D-uality/BitFusion-Robocup-Asia-Pacific/RPi Zero 2W/Design/Claw/Claw Mechanism/Claw Mechanism - Right Main Arm.stl

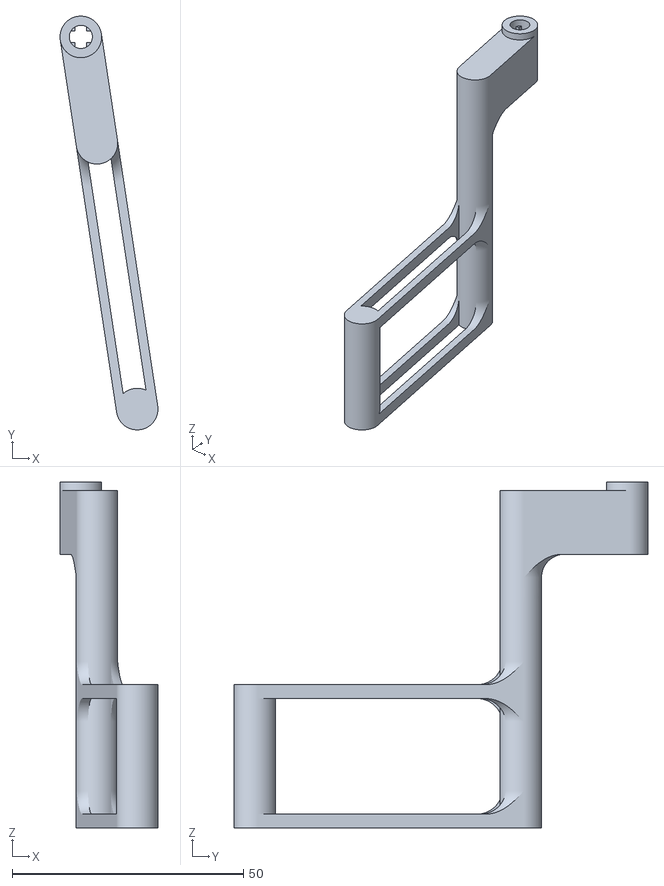
[picture p6: CAD file, 2024-09-25]
RPi Zero 2W/Design/Claw/Claw Mechanism/Claw Mechanism - Right Main Arm.stl
21.2 x 89.5 x 74.8
