D-uality/BitFusion-Robocup-Asia-Pacific/Design/RPi 5/Base Boards/Base Board - RPi 5 - Base Board - RPi 5.stl

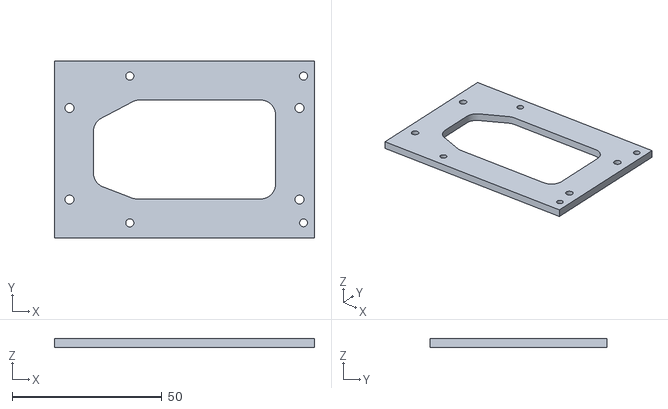
[picture p7: CAD file, 2024-06-18]
Design/RPi 5/Base Boards/Base Board - RPi 5 - Base Board - RPi 5.stl
86.8 x 59.0 x 3.00
