D-uality/BitFusion-Robocup-Asia-Pacific/Design/RPi 5/Battery/Battery Connector - Battery Connector.stl

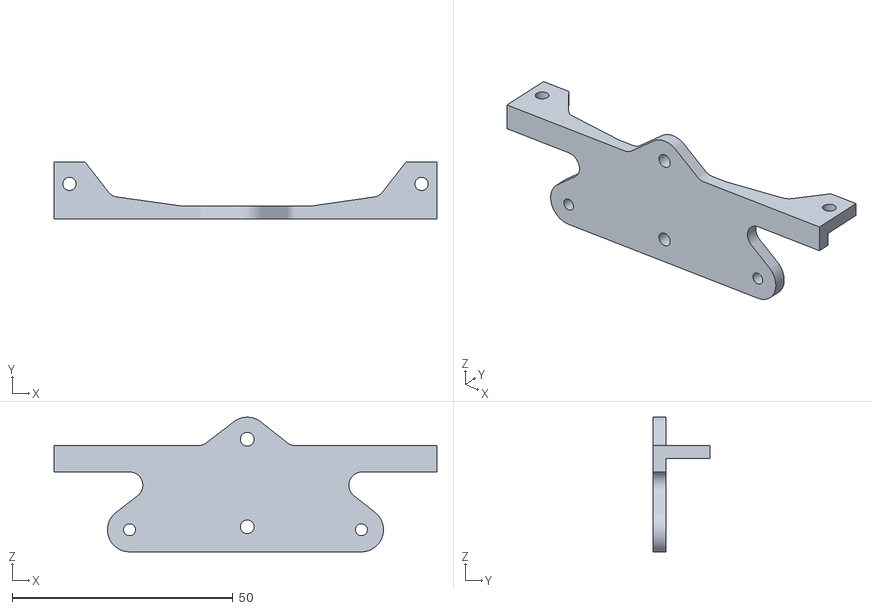
[picture p8: CAD file, 2024-06-18]
Design/RPi 5/Battery/Battery Connector - Battery Connector.stl
86.8 x 13.0 x 30.5
