D-uality/BitFusion-Robocup-Asia-Pacific/Design/RPi 5/Camera/Reflective Mirror - Reflective Mirror.stl

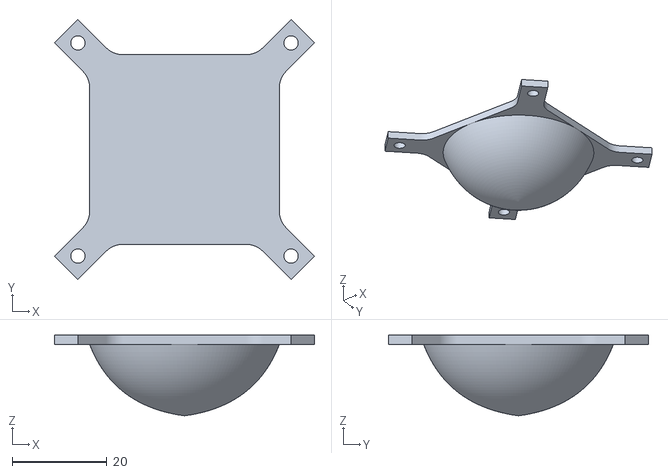
[picture p9: CAD file, 2024-06-18]
Design/RPi 5/Camera/Reflective Mirror - Reflective Mirror.stl
54.8 x 54.8 x 17.0
