D-uality/BitFusion-Robocup-Asia-Pacific/RPi Zero 2W/Design/Claw/Claw Frame/Claw Frame - Claw Vertically Up - Claw Frame.stl

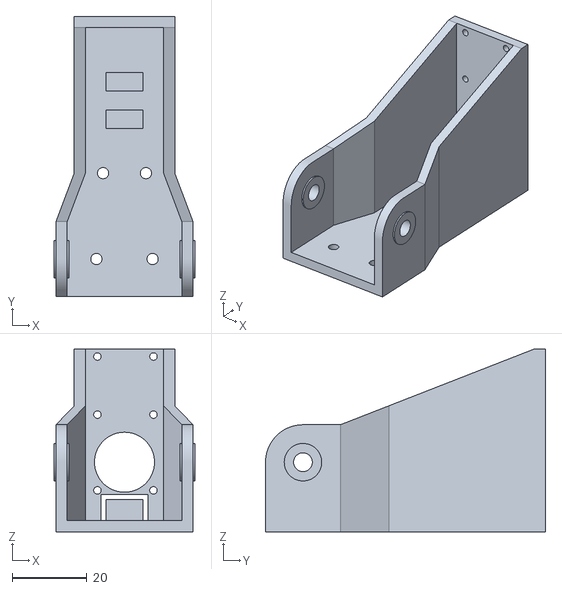
[picture p10: CAD file, 2024-06-18]
RPi Zero 2W/Design/Claw/Claw Frame/Claw Frame - Claw Vertically Up - Claw Frame.stl
37.6 x 74.7 x 48.8
