D-uality/BitFusion-Robocup-Asia-Pacific/RPi Zero 2W/Design/Claw/Claw Mechanism/Claw Mechanism - Left Bottom Cuff.stl

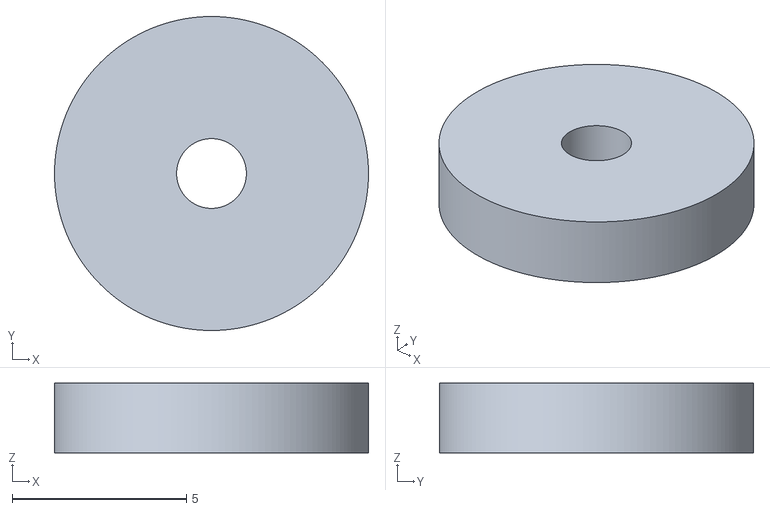
[picture p11: CAD file, 2024-09-25]
RPi Zero 2W/Design/Claw/Claw Mechanism/Claw Mechanism - Left Bottom Cuff.stl
9.00 x 9.00 x 2.00
