D-uality/BitFusion-Robocup-Asia-Pacific/RPi Zero 2W/Design/Claw/Drive Gears/Drive Gears - Drive Gear Front.stl

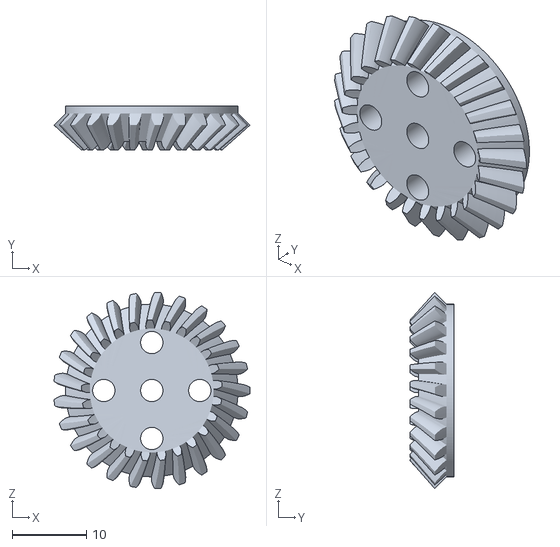
[picture p12: CAD file, 2024-06-18]
RPi Zero 2W/Design/Claw/Drive Gears/Drive Gears - Drive Gear Front.stl
26.4 x 5.92 x 26.4
