D-uality/BitFusion-Robocup-Asia-Pacific/RPi Zero 2W/Design/Claw/Rotating Frame/Rotating Frame - Rotating Frame.stl

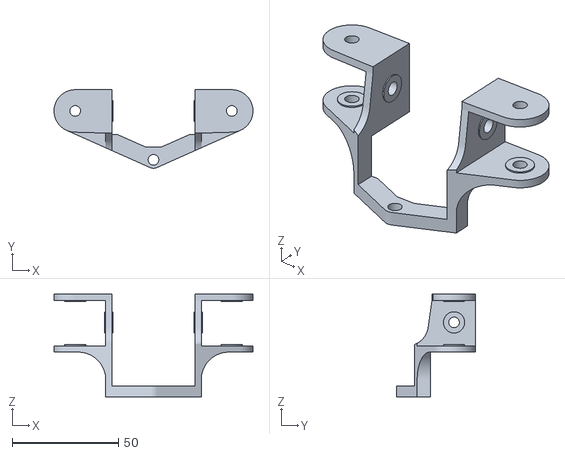
[picture p13: CAD file, 2024-09-07]
RPi Zero 2W/Design/Claw/Rotating Frame/Rotating Frame - Rotating Frame.stl
93.7 x 37.0 x 48.3
