D-uality/BitFusion-Robocup-Asia-Pacific/RPi Zero 2W/Design/Claw/Side Gears/Claw - Spiral Bevel 1M 15T 32deg.stl

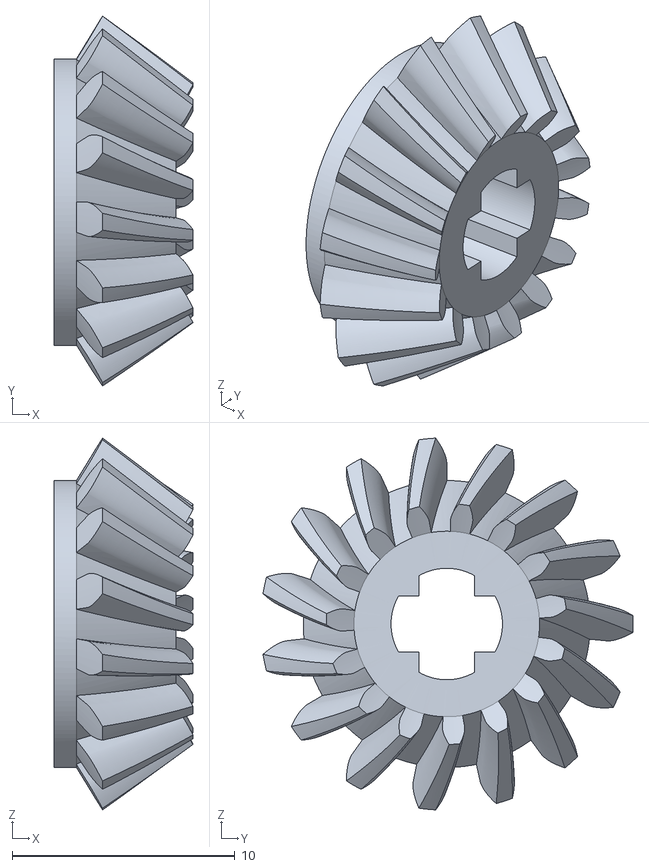
[picture p14: CAD file, 2024-06-18]
RPi Zero 2W/Design/Claw/Side Gears/Claw - Spiral Bevel 1M 15T 32deg.stl
6.23 x 16.6 x 16.7
