D-uality/BitFusion-Robocup-Asia-Pacific/RPi Zero 2W/Design/Robot/Lower Parts - Touch Frame.stl

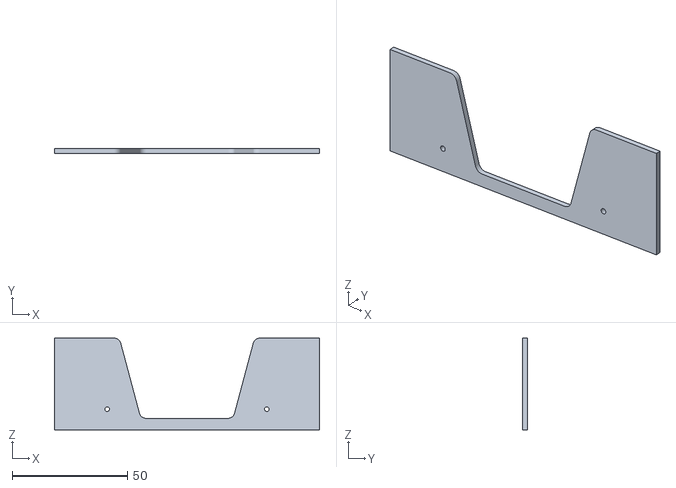
[picture p15: CAD file, 2024-10-12]
RPi Zero 2W/Design/Robot/Lower Parts - Touch Frame.stl
114.8 x 2.00 x 39.8
