D-uality/BitFusion-Robocup-Asia-Pacific/RPi Zero 2W/Design/Test/Lower Parts (22 deg).stl

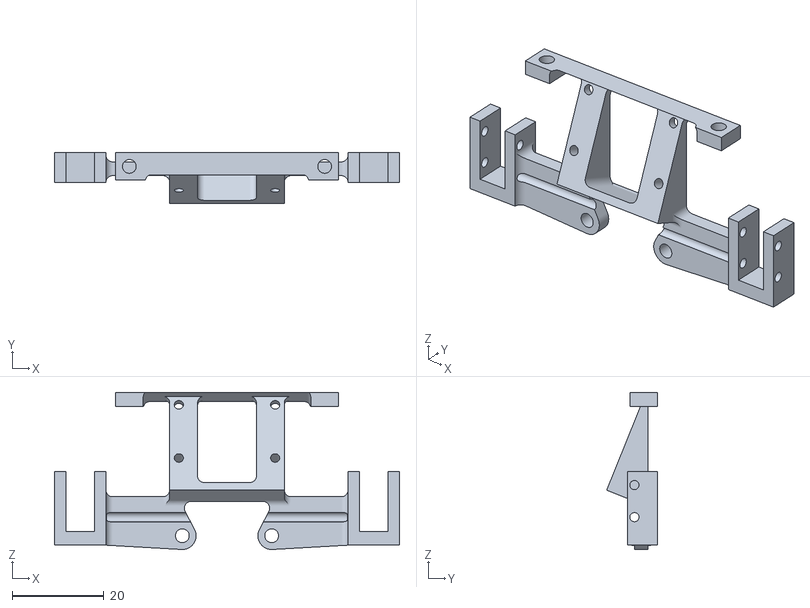
[picture p16: CAD file, 2024-07-22]
RPi Zero 2W/Design/Test/Lower Parts (22 deg).stl
75.2 x 11.0 x 34.2
