D-uality/BitFusion-Robocup-Asia-Pacific/Design/RPi 5/Base Boards/Base Board - Servos - Servo Base Board.stl

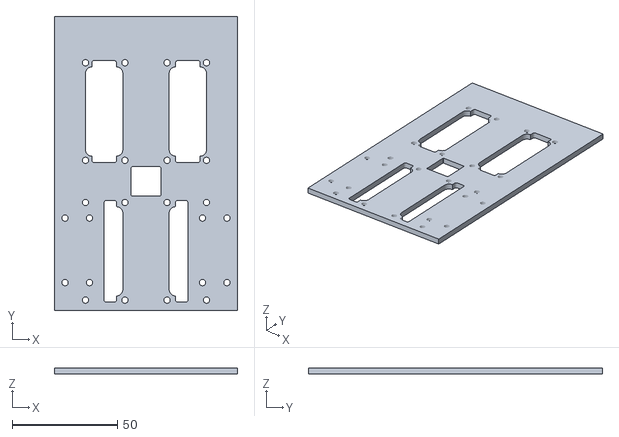
[picture p17: CAD file, 2024-06-18]
Design/RPi 5/Base Boards/Base Board - Servos - Servo Base Board.stl
86.8 x 139.6 x 3.00
