D-uality/BitFusion-Robocup-Asia-Pacific/Design/RPi 5/Battery/DoveTail - Battery Holder Dovetail.stl

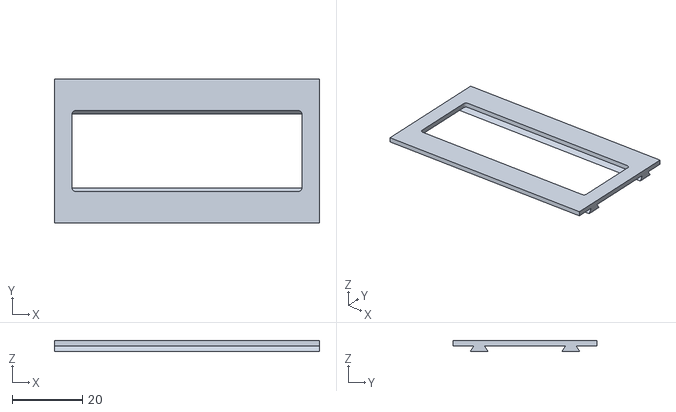
[picture p18: CAD file, 2024-05-27]
Design/RPi 5/Battery/DoveTail - Battery Holder Dovetail.stl
75.2 x 41.0 x 3.00
