D-uality/BitFusion-Robocup-Asia-Pacific/Design/RPi 5/Camera/Camera Frame - Camera Frame.stl

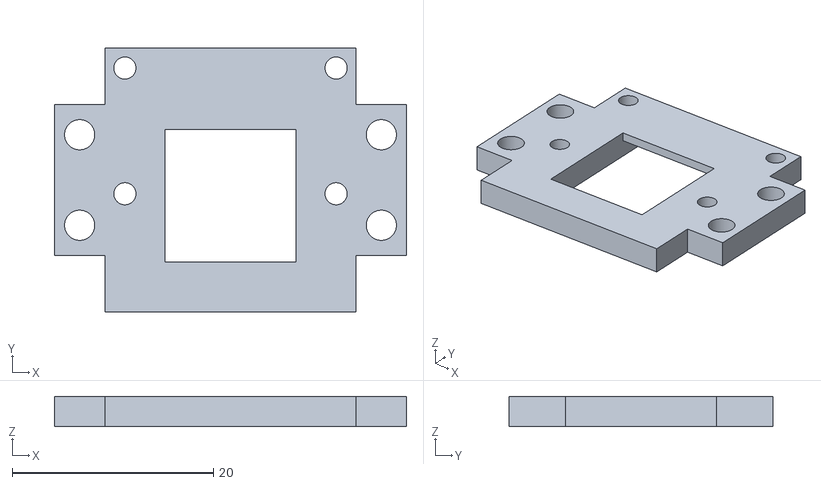
[picture p19: CAD file, 2024-06-18]
Design/RPi 5/Camera/Camera Frame - Camera Frame.stl
35.0 x 26.3 x 3.00
