D-uality/BitFusion-Robocup-Asia-Pacific/RPi Zero 2W/Design/Claw/Side Gears/Claw - Spiral Bevel 1M 24T 58deg.stl

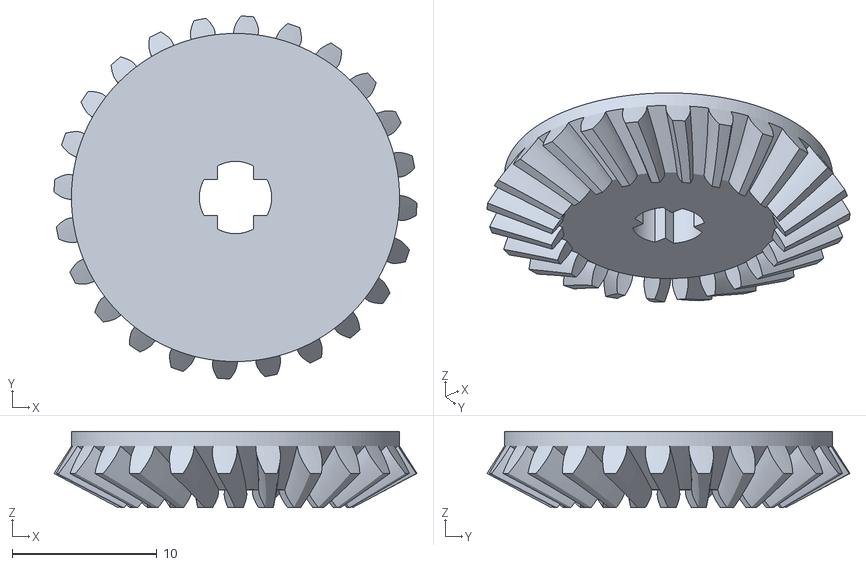
[picture p21: CAD file, 2024-06-18]
RPi Zero 2W/Design/Claw/Side Gears/Claw - Spiral Bevel 1M 24T 58deg.stl
25.1 x 25.1 x 5.26
