D-uality/BitFusion-Robocup-Asia-Pacific/RPi Zero 2W/Design/Robot/Touch Frame Back - Touch Frame Back.stl

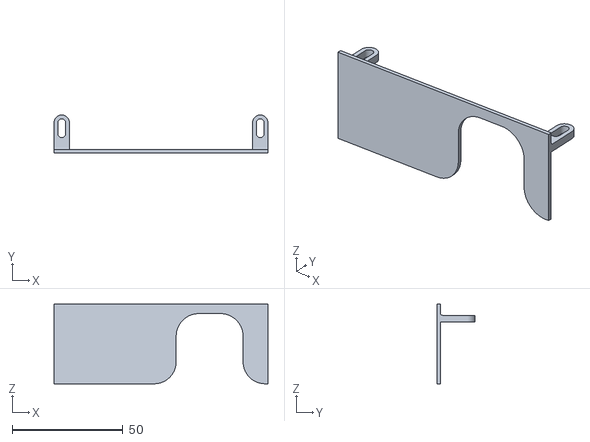
[picture p22: CAD file, 2024-10-12]
RPi Zero 2W/Design/Robot/Touch Frame Back - Touch Frame Back.stl
96.8 x 17.2 x 36.0
