D-uality/BitFusion-Robocup-Asia-Pacific/RPi Zero 2W/Design/Test/Lower Parts (20 deg).stl

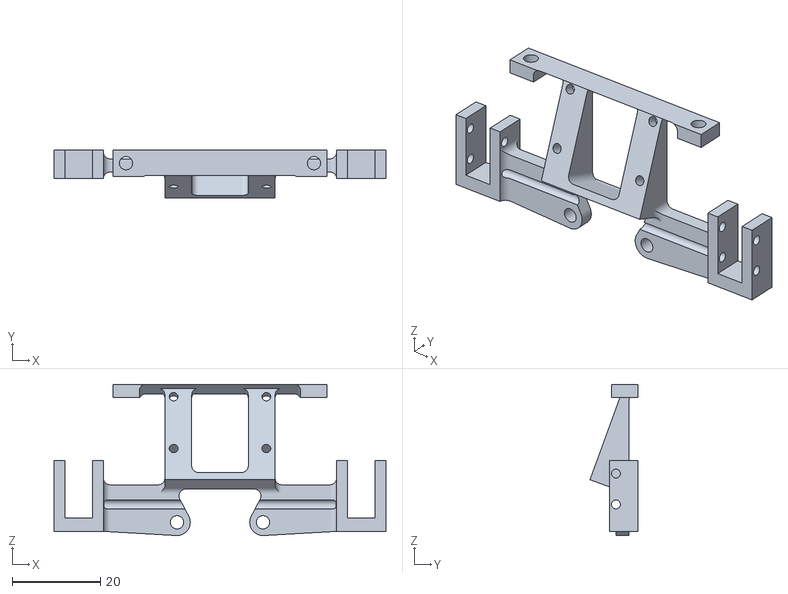
[picture p23: CAD file, 2024-07-22]
RPi Zero 2W/Design/Test/Lower Parts (20 deg).stl
75.2 x 10.9 x 34.2
