D-uality/BitFusion-Robocup-Asia-Pacific/Design/RPi 5/Battery/DoveTail - Test Piece.stl

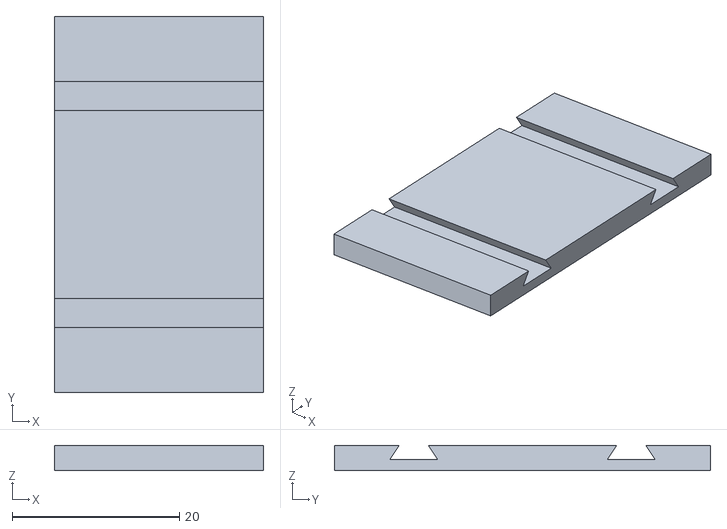
[picture p24: CAD file, 2024-05-27]
Design/RPi 5/Battery/DoveTail - Test Piece.stl
25.0 x 45.0 x 3.00
