D-uality/BitFusion-Robocup-Asia-Pacific/RPi Zero 2W/Design/Robot/Handle - Tilt Holder.stl

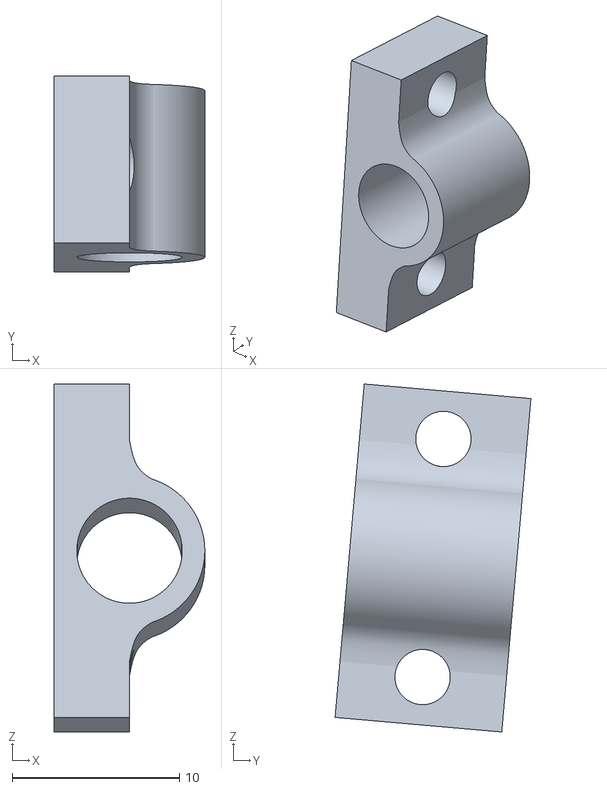
[picture p25: CAD file, 2024-10-05]
RPi Zero 2W/Design/Robot/Handle - Tilt Holder.stl
9.00 x 11.7 x 20.8
