D-uality/BitFusion-Robocup-Asia-Pacific/RPi Zero 2W/Design/Test/Lower Parts (10 deg).stl

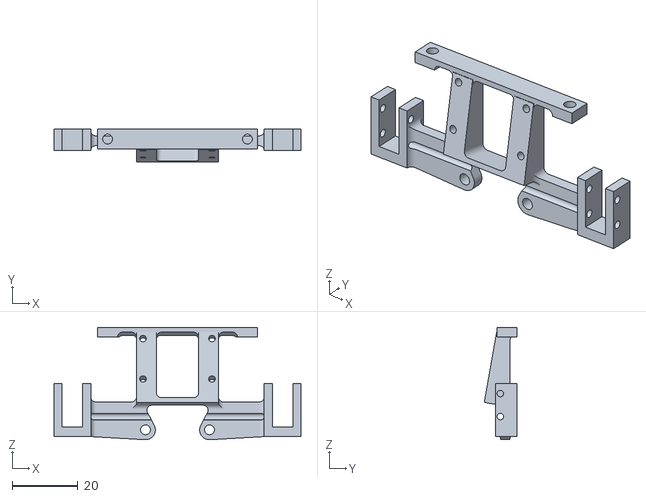
[picture p26: CAD file, 2024-07-22]
RPi Zero 2W/Design/Test/Lower Parts (10 deg).stl
75.2 x 9.90 x 34.2
