D-uality/BitFusion-Robocup-Asia-Pacific/RPi Zero 2W/Design/Robot/IR Sensor Board Frame - IR Sensor Board Frame.stl

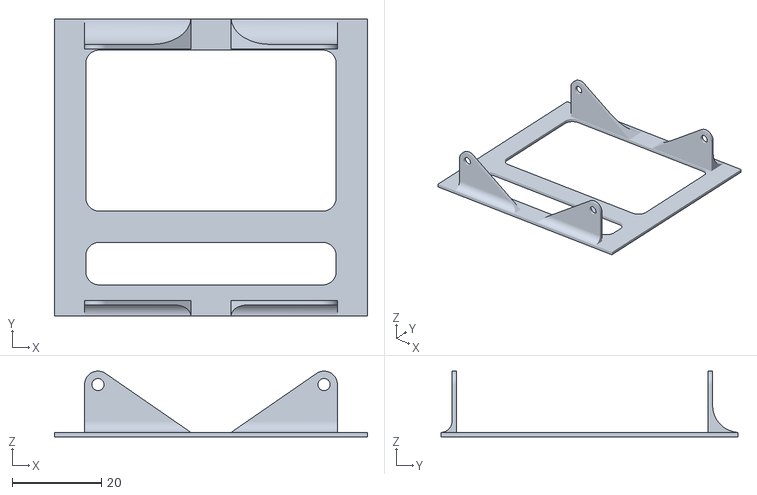
[picture p27: CAD file, 2024-09-25]
RPi Zero 2W/Design/Robot/IR Sensor Board Frame - IR Sensor Board Frame.stl
70.0 x 66.5 x 14.7
