D-uality/BitFusion-Robocup-Asia-Pacific/RPi Zero 2W/Design/Robot/Lower Parts - Slider Left.stl

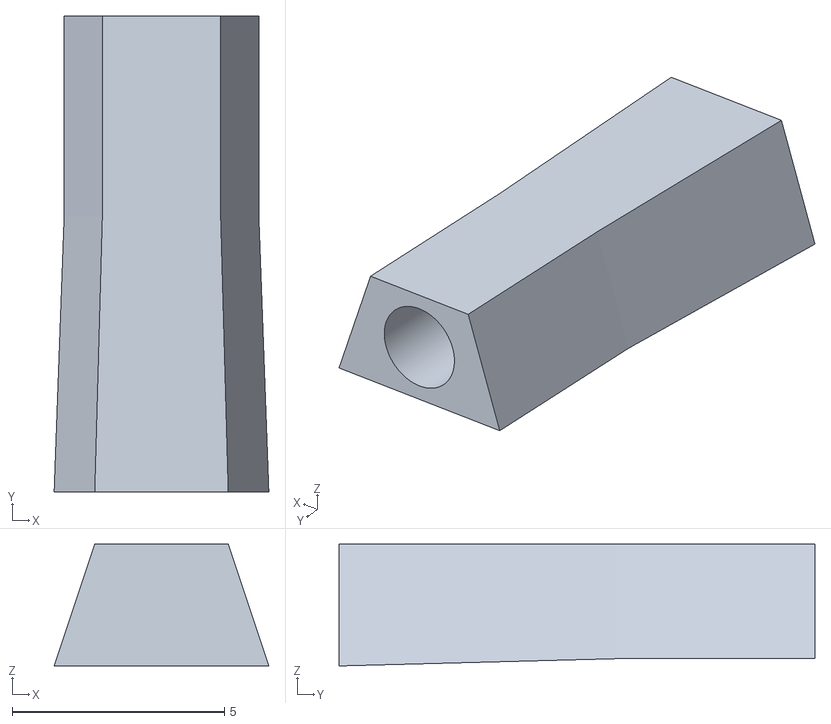
[picture p28: CAD file, 2024-09-08]
RPi Zero 2W/Design/Robot/Lower Parts - Slider Left.stl
5.06 x 11.2 x 2.87
