D-uality/BitFusion-Robocup-Asia-Pacific/RPi Zero 2W/Design/Robot/Lower Parts - Lower Parts.stl

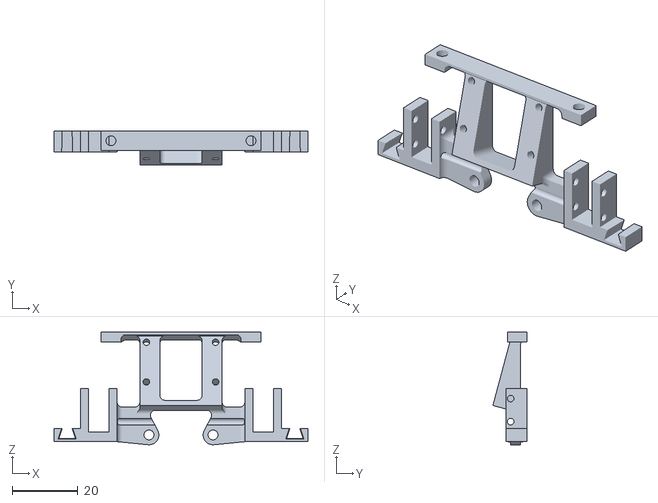
[picture p29: CAD file, 2024-09-08]
RPi Zero 2W/Design/Robot/Lower Parts - Lower Parts.stl
77.2 x 10.4 x 34.2
