D-uality/BitFusion-Robocup-Asia-Pacific/RPi Zero 2W/Design/Claw/Claw Mechanism/Claw Mechanism - Left Supporting Arm.stl

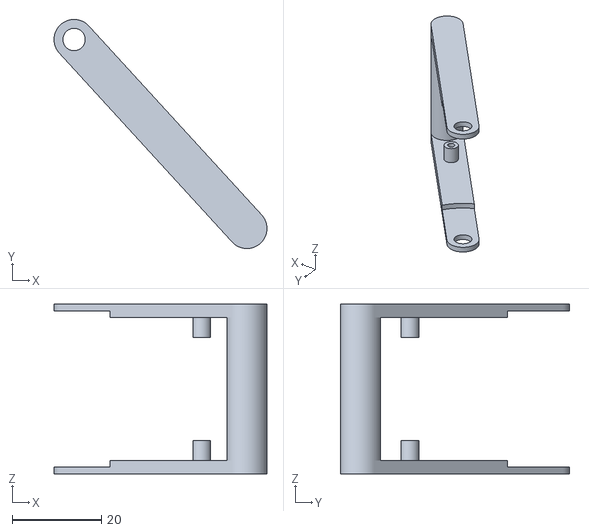
[picture p30: CAD file, 2024-09-25]
RPi Zero 2W/Design/Claw/Claw Mechanism/Claw Mechanism - Left Supporting Arm.stl
47.8 x 51.4 x 38.0
