D-uality/BitFusion-Robocup-Asia-Pacific/RPi Zero 2W/Design/Robot/Base Board - Claw - Base Board - Claw.stl

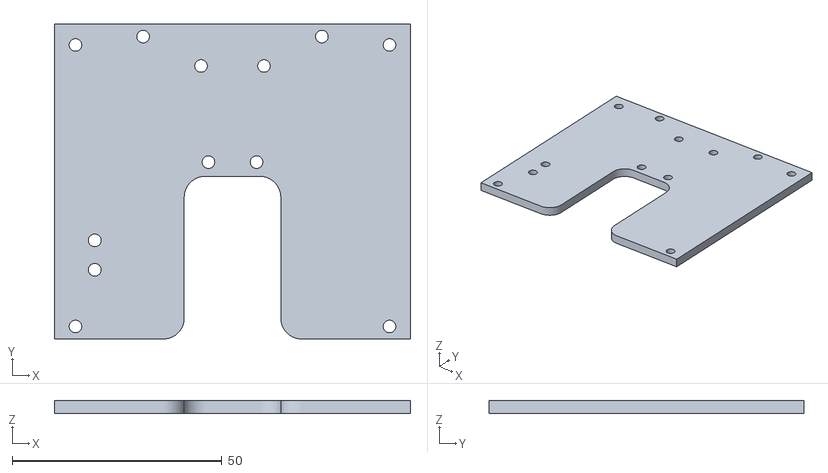
[picture p31: CAD file, 2024-07-22]
RPi Zero 2W/Design/Robot/Base Board - Claw - Base Board - Claw.stl
84.8 x 75.1 x 3.00
