D-uality/BitFusion-Robocup-Asia-Pacific/RPi Zero 2W/Design/Robot/Robot - Camera Frame.stl

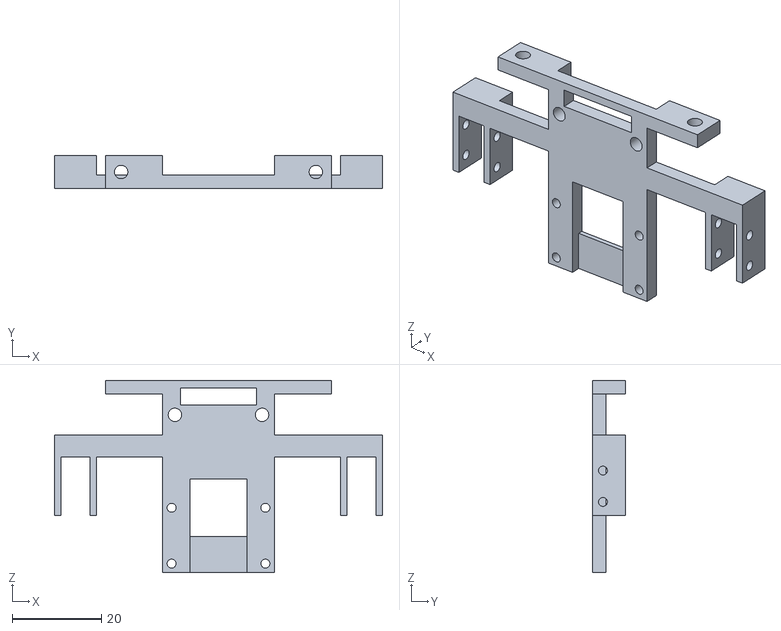
[picture p32: CAD file, 2024-07-18]
RPi Zero 2W/Design/Robot/Robot - Camera Frame.stl
73.4 x 7.30 x 43.0
