D-uality/BitFusion-Robocup-Asia-Pacific/RPi Zero 2W/Design/Robot/Side Laser Frame.stl

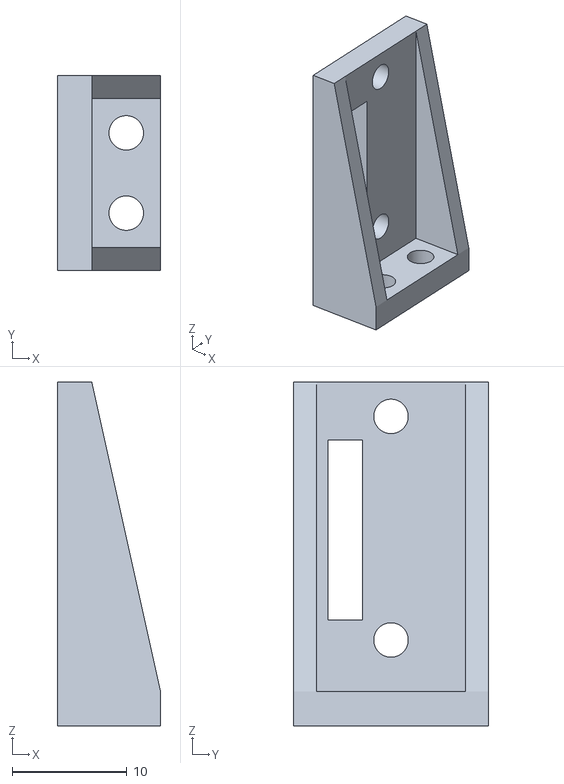
[picture p33: CAD file, 2024-06-28]
RPi Zero 2W/Design/Robot/Side Laser Frame.stl
9.00 x 17.0 x 30.0
