D-uality/BitFusion-Robocup-Asia-Pacific/RPi Zero 2W/Design/Robot/Handle - Handle.stl

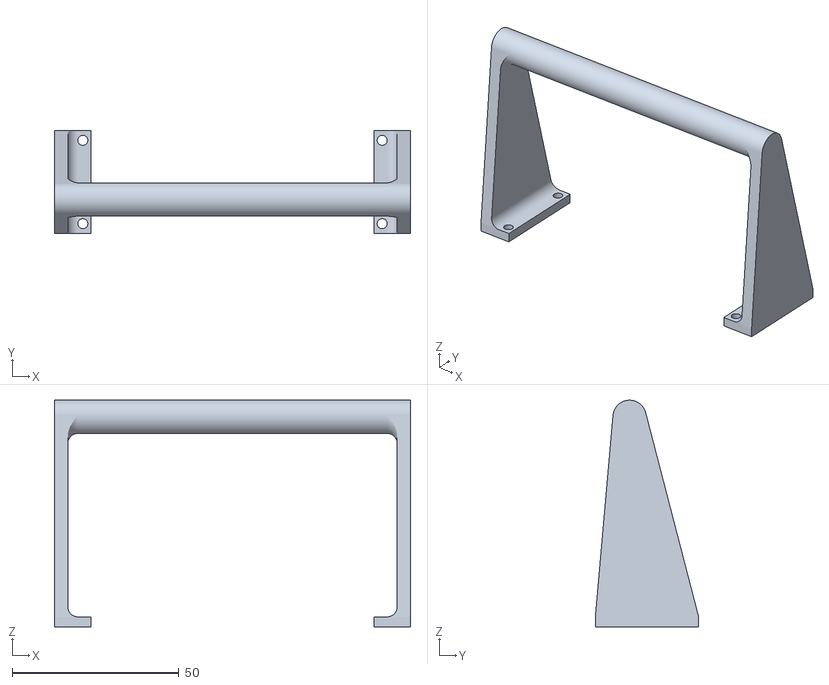
[picture p34: CAD file, 2024-06-18]
RPi Zero 2W/Design/Robot/Handle - Handle.stl
106.8 x 31.0 x 68.0
