D-uality/BitFusion-Robocup-Asia-Pacific/RPi Zero 2W/Design/Robot/Base Board - Servo - Base Board - Servos.stl

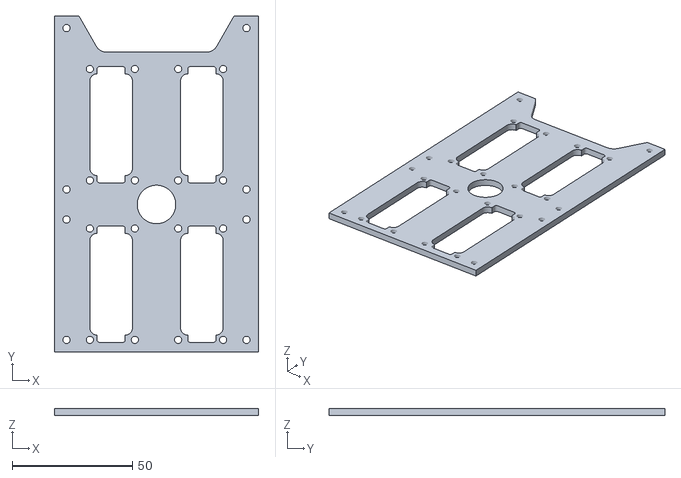
[picture p35: CAD file, 2024-06-18]
RPi Zero 2W/Design/Robot/Base Board - Servo - Base Board - Servos.stl
84.8 x 139.6 x 3.00
