D-uality/BitFusion-Robocup-Asia-Pacific/RPi Zero 2W/Design/Robot/Voltage Regulator Frame - Voltage Regulator Frame.stl

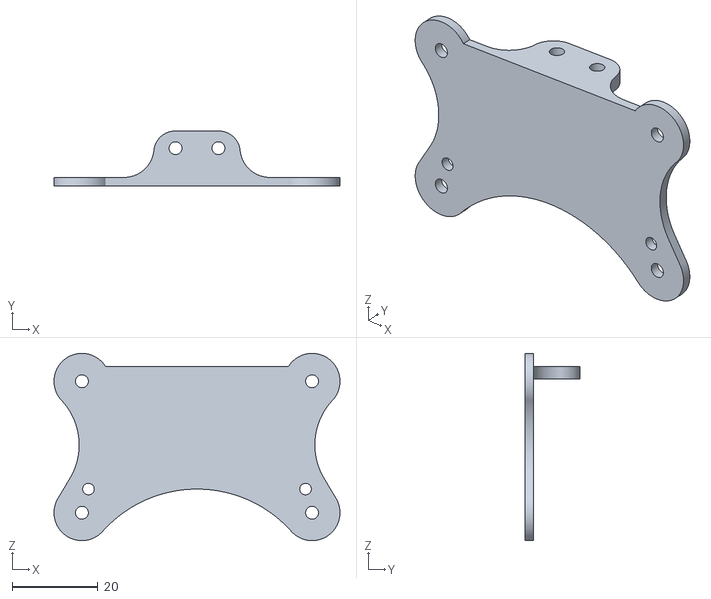
[picture p36: CAD file, 2024-06-18]
RPi Zero 2W/Design/Robot/Voltage Regulator Frame - Voltage Regulator Frame.stl
66.6 x 12.8 x 43.6
