D-uality/BitFusion-Robocup-Asia-Pacific/RPi Zero 2W/Design/Robot/Back Frame - Back Frame.stl

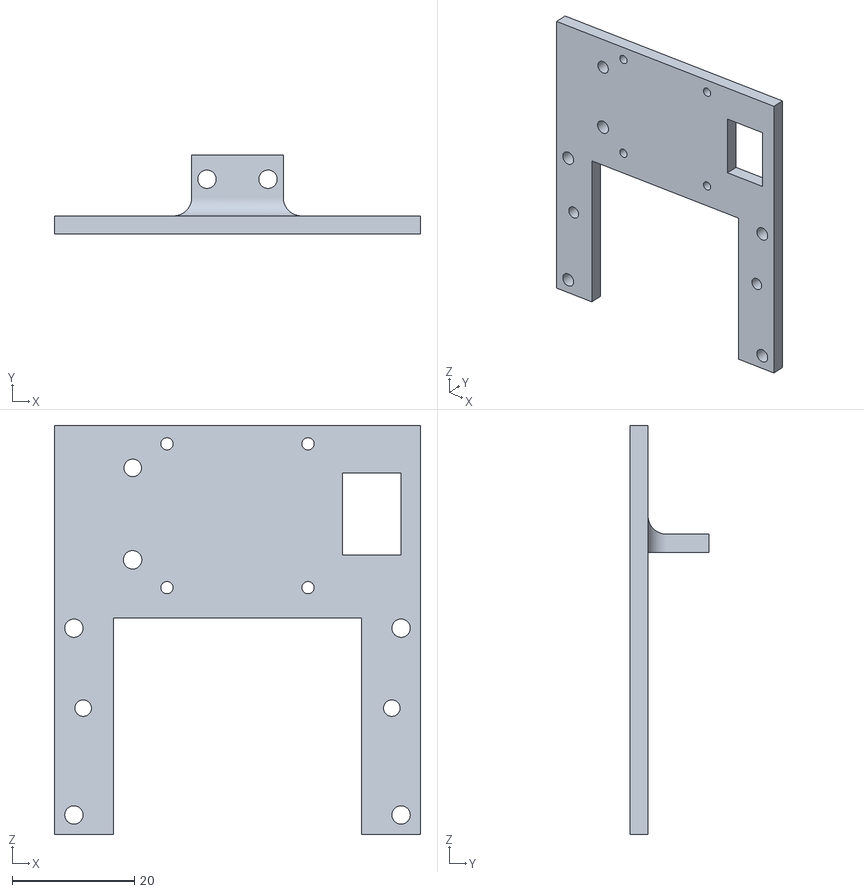
[picture p37: CAD file, 2024-06-18]
RPi Zero 2W/Design/Robot/Back Frame - Back Frame.stl
60.0 x 13.0 x 67.0
