D-uality/BitFusion-Robocup-Asia-Pacific/RPi Zero 2W/Design/Robot/Base Boards - Controller Board - Controller Base Board.stl

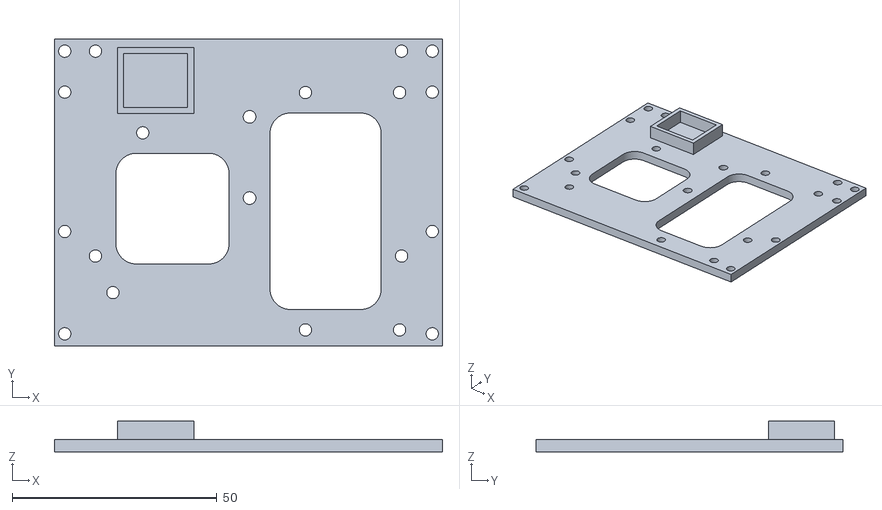
[picture p38: CAD file, 2024-06-18]
RPi Zero 2W/Design/Robot/Base Boards - Controller Board - Controller Base Board.stl
94.8 x 75.1 x 7.50
