D-uality/BitFusion-Robocup-Asia-Pacific/RPi Zero 2W/Design/Robot/Base Board - Battery - Base Boards - Battery.stl

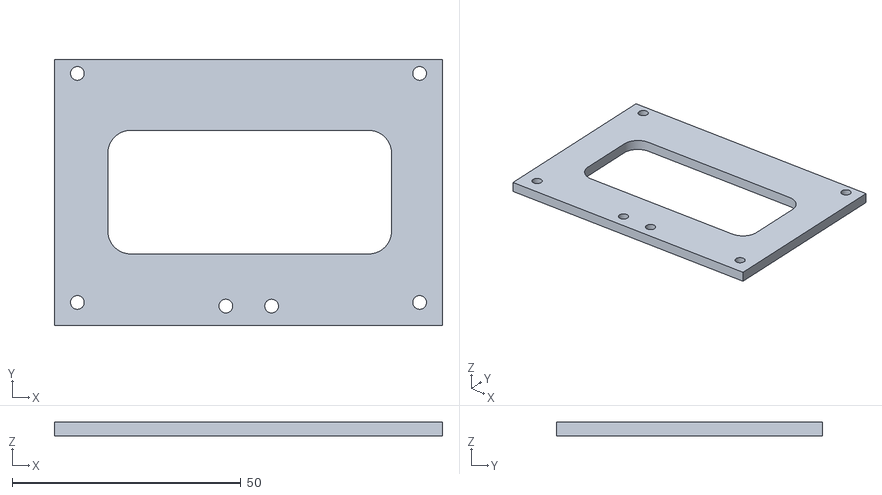
[picture p39: CAD file, 2024-06-18]
RPi Zero 2W/Design/Robot/Base Board - Battery - Base Boards - Battery.stl
84.8 x 58.0 x 3.00
