D-uality/BitFusion-Robocup-Asia-Pacific/RPi Zero 2W/Design/Robot/Wire Manager - Wire Manager.stl

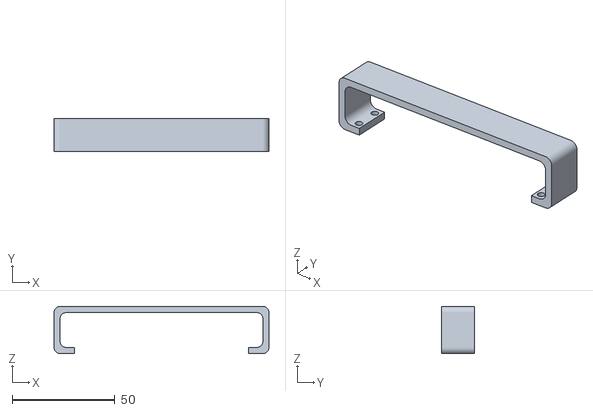
[picture p40: CAD file, 2024-06-18]
RPi Zero 2W/Design/Robot/Wire Manager - Wire Manager.stl
104.8 x 16.0 x 23.0
