D-uality/BitFusion-Robocup-Asia-Pacific/RPi Zero 2W/Design/Robot/Servo Frame.stl

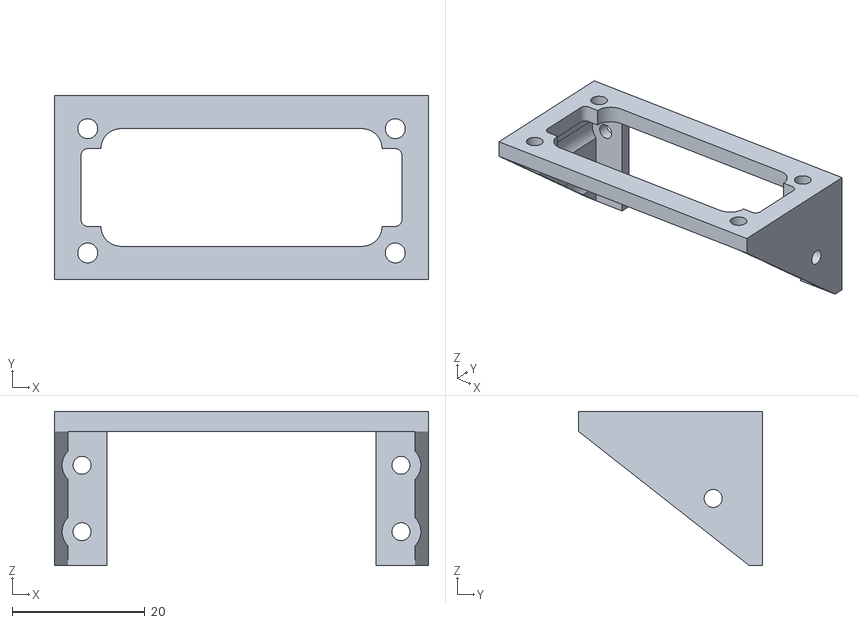
[picture p41: CAD file, 2024-05-27]
RPi Zero 2W/Design/Robot/Servo Frame.stl
56.3 x 27.7 x 23.2
