D-uality/BitFusion-Robocup-Asia-Pacific/(list of files, cad)

Other CAD files:
RPi Zero 2W/Design/Claw/Claw Mechanism/Claw Mechanism - Left Main Arm.stl
RPi Zero 2W/Design/Claw/Drive Gears/Drive Gears - Drive Gear Left.stl
RPi Zero 2W/Design/Claw/Claw Mechanism/Claw Mechanism - Right Top Cuff.stl
RPi Zero 2W/Design/Claw/Claw Mechanism/Claw Mechanism - Left Top Cuff.stl
RPi Zero 2W/Design/Claw/Claw Mechanism/Claw Mechanism - Right Bottom Cuff.stl
RPi Zero 2W/Design/Robot/Lower Parts - Slider Right.stl
RPi Zero 2W/Design/Claw/Claw Mechanism/Claw Mechanism - Right Supporting Arm.stl
