D-uality/BitFusion-Robocup-Asia-Pacific/RPi Zero 2W/Test Programs/servo_calibration/Servo Calibration.xlsm

 |  | PWM frequency / Hz
Time Taken for 5 rotations / S | Servo Number | -450 | -400 | -300 | -200 | -150 | 150 | 200 | 300 | 400 | 450
 | Bot Left |  | -6 | -8.88 | -16.67 | -30.54 | 26.03 | 14.89 | 8.22 | 5.73
 | Top Left |  | -5.01 | -6.9 | -11.38 | -17.09 | 16.91 | 11.12 | 6.79 | 5
 | Top Right |  | -5.66 | -8.06 | -14.61 | -24.69 | 23.27 | 13.38 | 7.64 | 5.32
 | Bot Right |  | -5.85 | -8.09 | -14.51 | -24.96 | 20.79 | 12.85 | 7.36 | 5.31
