D-uality/BitFusion-Robocup-Asia-Pacific/RPi Zero 2W/version_4_short_long_range/config.py

HEIGHT = 800
WIDTH  = 1000
CROP_HEIGHT_UPPER = 100
CROP_HEIGHT_LOWER = HEIGHT
REDUCTION_HEIGHT = 480
REDUCTION_WIDTH  = 520

SSH = True
