D-uality/BitFusion-Robocup-Asia-Pacific/RPi Zero 2W/version_5_spectral_highlight/main.py

import cv2
import numpy as np
from picamera2 import Picamera2, Preview
from libcamera import Transform, controls
import time
import serial

from config import *
from camera import *
from imageTransform import *
from victim import *
from triangles import *
from presence import *

com = serial.Serial('/dev/ttyS0', 115200, timeout=1)

def convertStringToBytes(message):
  return list(map(ord, message))

try:
  while True:
    timeStart = time.time()

    image = camera.capture_array()
    imageClean = image.copy()
    image = image[CROP_MIN:CROP_MAX][:]

    image, spectralHighlightMask = findSpectralHighlights(image, 10)
    rgb_image, green, red, black, yellow = generateMasks(image)

    xLive, yLive = findLiveVictims(spectralHighlightMask, rgb_image)
    xDead, yDead = findDeadVictims(black, rgb_image)

    rgb_image, greenX, redX = findTriangles(rgb_image, green, red, xDead, xLive)
    presence = presenceCheck(rgb_image, yellow, black)

    data = "0" + str(xLive) + " " + str(xDead) + " " + str(greenX) + " " + str(redX)  + " " + str(presence)
    print(f"Sending {data}", end="    ")
    com.write(convertStringToBytes(data))

    if SSH:
      show_image = cv2.cvtColor(rgb_image, cv2.COLOR_RGB2BGR)
      cv2.imshow("image", show_image)
      cv2.imshow("clean", imageClean)
      cv2.imshow("black", black)
      cv2.imshow("green", green)
      cv2.imshow("red", red)

    print(f"|    {(1 / (time.time() - timeStart)):.2f} pc/s")

except KeyboardInterrupt:
  print("Exiting program!")
