D-uality/BitFusion-Robocup-Asia-Pacific/Teensy 4.1/Rescue Line V4/Line.cpp

#include "Functions.h"

//  Note: Index 0 = Left, Index 1 = Right

//  ----------------------------------------  Main Loop & General Functions
bool evacExited = 0;
const int blackMax = 10;
const int blackWhite = 40;

void running() {
  readColourSensors(1);
  readTouchSensors(0);
  checkGreen();
  if(!evacExited) findEvacLine();
  if(evacExited) findFinishLine();
  if((leftBlack && leftGreen) || (rightBlack && rightGreen) || (doubleBlack[0] && doubleGreen[0]) || (doubleBlack[1] && doubleGreen[1])) detectGreen();
  else if(touchValues[0] == 0 && touchValues[1] == 0) avoidObstacle();
  else lineFollow();
}

void alignBlack(int alignmentType) {
  if(alignmentType == 0) {
    Serial.println("Aligning to Line from Left");
    runMotors(lineSpeed[1] + 20, lineSpeed[1] + 20, 400);
    runUntil(blackMax, colourPins[0], 0, -lineSpeed[1], lineSpeed[1], 900);
    runUntil(blackWhite, colourPins[4], 0, -lineSpeed[0], lineSpeed[0], 900);
  }

  else if(alignmentType == 1) {
    Serial.println("Aligning to Line from Right");
    runMotors(lineSpeed[1] + 20, lineSpeed[1] + 20, 400);
    runUntil(blackMax, colourPins[3], 0, lineSpeed[1], -lineSpeed[1], 900);
    runUntil(blackWhite, colourPins[1], 0, lineSpeed[0], -lineSpeed[0], 900);
  }

  else if(alignmentType == 2) {
    Serial.println("Aligning to Line from Double");
    runMotors(lineSpeed[1] + 80, -lineSpeed[1] - 80, 1800);
    runUntil(blackMax, colourPins[3], 0, lineSpeed[1], -lineSpeed[1], 900);
    runUntil(blackMax, colourPins[1], 0, lineSpeed[0], -lineSpeed[0], 900);
  }
}

//  ----------------------------------------  Line Following Function
const float outerMultiplier = 5;
const float innerMultiplier = 5;
const float backMultiplier = 2.5;
const int lineSpeed[2] = {230, 320};
// const int forwardSpeed[2] = {800, 890};  //  Ramp Speed Bump speed
int backError = 0;

void lineFollow() {
  //  Calculate turn
  int outerError = outerMultiplier * (colourValuesMapped[0] - colourValuesMapped[3]);
  int innerError = innerMultiplier * (colourValuesMapped[1] - colourValuesMapped[4]);
  if(colourValuesMapped[2] < greenMax[0] || colourValuesMapped[5] < greenMax[1]) backError = backMultiplier * (colourValuesMapped[2] - colourValuesMapped[5]);
  else backError = 0;

  //  Total turn value
  int lineError = outerError + innerError + backError;

  runMotors(lineSpeed[0] + lineError, lineSpeed[1] - lineError, 0);
}

//  ----------------------------------------  Green Intersection Functions
const int greenMin[2] = {12, 15};
const int greenMax[2] = {25, 25};
bool leftBlack = 0;
bool rightBlack = 0;
bool doubleBlack[2] = {0, 0};
bool leftGreen = 0;
bool rightGreen = 0;
bool doubleGreen[2] = {0, 0};

void checkGreen() {
  //  Black Variables for checking for black and their corresponding sides
  leftBlack = colourValuesMapped[0] < blackMax && colourValuesMapped[1] < blackMax;
  rightBlack = colourValuesMapped[3] < blackMax && colourValuesMapped[4] < blackMax;
  doubleBlack[0] = leftBlack && colourValuesMapped[3] < blackMax + 30 && colourValuesMapped[4] < blackMax + 30;
  doubleBlack[1] = rightBlack && colourValuesMapped[0] < blackMax + 30 && colourValuesMapped[1] < blackMax + 30;

  //  Green Variables for checking for green and their correspoding sides
  leftGreen = colourValuesMapped[2] > greenMin[0] && colourValuesMapped[2] < greenMax[0];
  rightGreen = colourValuesMapped[5] > greenMin[1] && colourValuesMapped[5] < greenMax[1];
  doubleGreen[0] = leftGreen && colourValuesMapped[5] > greenMin[1] - 5 && colourValuesMapped[5] < greenMax[1] + 5;
  doubleGreen[1] = rightGreen && colourValuesMapped[2] > greenMin[0] - 5 && colourValuesMapped[2] < greenMax[0] + 5;
}

void detectGreen() {
  Serial.print("Green Intersections: ");
  if ((doubleBlack[0] && doubleGreen[0]) || (doubleBlack[1] && doubleGreen[1])) {
    Serial.println("Double");
    readColourSensors(1);
    alignBlack(2);
  }

  else if (leftBlack && leftGreen) {
    Serial.println("Left");
    readColourSensors(1);
    alignBlack(0);
  } 
  
  else if (rightBlack && rightGreen) {
    Serial.println("Right");
    readColourSensors(1);
    alignBlack(1);
  }

  else {
    Serial.println("None");
    readColourSensors(1);
  }
}

//  ----------------------------------------  Obstacle Avoidance Functions
bool colourIsBlack[2] = {0, 0};

void circleObstacle(bool rightLaser, int turnType, bool moreThan, bool checkBlack) {
  bool laserConditionMet = 0;
  long startingTime = millis();
  int currentTime = 0;

  do {
    //  Determine movement around the obstacle
    if(turnType == 1) runMotors(300, 300, 0);
    if(turnType == 2) runMotors(300, -300, 0);
    if(turnType == 3) runMotors(-300, 300, 0);
    //  Debugging in Serial Monitor
    readColourSensors(1);
    readLaserSensors(1);
    readTouchSensors(1);

    // //  No debugging in Serial Monitor
    // readColourSensors(0);
    // readLaserSensors(0);
    // readTouchSensors(0);

    //  Inputed aser condition is met if laser sees more than 100 or less than 300
    laserConditionMet = (distance[rightLaser] > 100 && moreThan) || (distance[rightLaser] < 100 && !moreThan);

    //  Check for black
    if(checkBlack) {
      colourIsBlack[0] = (colourValuesMapped[1] < blackMax + 20 && !colourIsBlack[0]) || colourIsBlack[0];
      colourIsBlack[1] = (colourValuesMapped[4] < blackMax + 20 && !colourIsBlack[1]) || colourIsBlack[1];
    }

    //  If running into a wall, turn slightly away from the wall
    for(int touchSide = 0; touchSide < 1; touchSide++) {
      if(touchValues[touchSide] == 0 && turnType == 1) {
        if(touchSide == 0) runMotors(300, -300, 200);
        if(touchSide == 1) runMotors(-300, 300, 200);

        //  Update sensor readings after movement
        readColourSensors(0);
        readLaserSensors(0);
        readTouchSensors(0);
      }
    }

    Serial.println(laserConditionMet);
    //  Update Time
    currentTime = millis() - startingTime;
  }
  //  While laser condition not met, and time not met, or front sensors haven't seen black
  while((!laserConditionMet || currentTime < 500) && (!colourIsBlack[0] || !colourIsBlack[1]));
}

void avoidObstacle() {
  Serial.println("Obstacle Detected");
  colourIsBlack[0] = 0, colourIsBlack[1] = 0;

  //  Update Laser Values
  runMotors(0, 0, 1000);
  for(int readLasers = 0; readLasers < 100; readLasers++) readLaserSensors(0);  //  Refreshs laser sensors to be read accurately
  readLaserSensors(1);

  if(distance[0] > distance[1]) {  //  Check for walls on left or right side of robot
    Serial.println("Going Left");
    //  Turn left, go forwards
    circleObstacle(1, 3, 0, 0);
    circleObstacle(1, 1, 1, 0);

    Serial.println("Left Obstacle Loop Phase");
    while(colourIsBlack[0] == 0) {
      //  Forward, then turn right until left side sees black line
      circleObstacle(1, 2, 1, 1);
      circleObstacle(1, 1, 1, 1);
    }

    alignBlack(0);
  }
  else {
    Serial.println("Going Right");
    //  Turn right, go forwards
    circleObstacle(0, 2, 0, 0);
    circleObstacle(0, 1, 1, 0);

    Serial.println("Right Obstacle Loop Phase");
    while(colourIsBlack[1] == 0) {
      //  Forward, then turn left until right side sees black line
      circleObstacle(0, 3, 1, 1);
      circleObstacle(0, 1, 1, 1);
    }

    alignBlack(1);
  }
}

//  ----------------------------------------  Checking Evac Zone Function
int silverDetected = 0;
const int silverMin = 150;
int redDetected = 0;
const int redMin = 60;
const int redMax = 85;

void findEvacLine() {
  if(colourValuesMapped[0] > silverMin || colourValuesMapped[1] > silverMin) silverDetected++;
  else silverDetected = 0;

  if(silverDetected > 50) {
    Serial.println("Evac Zone Found!");
    runMotors(0, 0, 5000);
    //  routeEvac();
  }
}

void findFinishLine() {
  //  Checking for red lines on back colour sensors
  for(int sensorNum = 2; sensorNum < 6; sensorNum = sensorNum + 3) {
    if(colourValuesMapped[sensorNum] > redMin && colourValuesMapped[sensorNum] < redMax) redDetected++;
    else redDetected = 0;
  }

  //  If read lines of all colour sensors found "Threhold" times then finish line is found
  const int redDetectionThreshold = 200;
  if(redDetected > 2 * redDetectionThreshold) {
    Serial.println("Finish Line Found!");
    mode = 's';
  }
}
