D-uality/BitFusion-Robocup-Asia-Pacific/RPi Zero 2W/version_5_spectral_highlight/triangles.py

from config import *
import cv2
import numpy as np
import random
import math

def findTriangles(image, green, red, xDead, xLive):
  greenX, redX = 0, 0
  
  greenContours, _ = cv2.findContours(green, cv2.RETR_EXTERNAL, cv2.CHAIN_APPROX_SIMPLE)
  greenContours = verifyGreenContours(greenContours)
  redContours, _   = cv2.findContours(red, cv2.RETR_EXTERNAL, cv2.CHAIN_APPROX_SIMPLE)

  image, greenX, greenY = positionContour(image, greenContours, xDead, xLive)
  image, redX, _        = positionContour(image, redContours, xDead, xLive)
  # greenX = verifyGreen(greenX, greenY, green)
  
  return image, greenX, redX

def verifyGreenContours(contours):
  approvedContours = []

  for contour in contours:
    if isCircle(contour) == True: pass
    else: approvedContours.append(contour)
  
  return approvedContours

def isCircle(contour, circularity_threshold=0.7):
  perimeter = cv2.arcLength(contour, True)
  area = cv2.contourArea(contour)

  if perimeter == 0:
    return False

  circularity = (4 * np.pi * area) / (perimeter ** 2)

  if(circularity > circularity_threshold): return True
  else: return False

def generateRandomPoints(xCenter, yCenter, radius, numberOfPoints):
  points = []
  cycles = 0

  while len(points) < numberOfPoints and cycles < 15:
    angle = random.uniform(0, 2 * math.pi)
    r = math.sqrt(random.uniform(0, 1)) * radius
    x = int(xCenter + r * math.cos(angle))
    y = int(yCenter + r * math.sin(angle))

    if x < 0 or y < 0 or x > WIDTH - 1 or y > HEIGHT - 1:
      pass
    else:
      points.append((x, y))
    cycles += 1

  return points

def positionContour(image, contours, xDead, xLive):
  maxContour = getMaxAreaContour(contours)

  if maxContour is None:
    return image, 0, 0

  cv2.drawContours(image, maxContour, -1, (0, 0, 255), 3)

  approx = approximateContour(maxContour)
  cv2.drawContours(image, [approx], -1, (0, 0, 255), 3)

  # print(len(approx))
  if len(approx) in [3, 4, 5]:
    points = [approx[i][0] for i in range(len(approx))]
    angles = calculateAngles(points)

    if any(isCloseTo90(angle) for angle in angles):
      x, y = getContourCenter(maxContour)
      return image, x, y
  elif xDead != 0 or xLive != 0:
    x, y = getContourCenter(maxContour)
    return image, x, y

  return image, 0, 0

def getMaxAreaContour(contours, min_area=6000):
  maxArea = 0
  maxContour = None

  for contour in contours:
    area = cv2.contourArea(contour)

    if area > maxArea and area > min_area:
      maxArea = area
      maxContour = contour

  return maxContour

def approximateContour(contour, epsilon_factor=0.04):
  epsilon = epsilon_factor * cv2.arcLength(contour, True)
  return cv2.approxPolyDP(contour, epsilon, True)

def calculateAngles(points):
  angles = []
  for i in range(len(points)):
    p1 = points[i]
    p2 = points[(i + 1) % len(points)]
    p3 = points[(i + 2) % len(points)]
    angle = calculateAngle(p1, p2, p3)
    angles.append(angle)
  return angles

def calculateAngle(p1, p2, p3):
  v1 = np.array([p1[0] - p2[0], p1[1] - p2[1]])
  v2 = np.array([p3[0] - p2[0], p3[1] - p2[1]])
  v1_norm = np.linalg.norm(v1)
  v2_norm = np.linalg.norm(v2)

  if v1_norm == 0 or v2_norm == 0:
    return 0

  dot_product = np.dot(v1, v2)
  angle = np.arccos(dot_product / (v1_norm * v2_norm))
  angle = np.degrees(angle)

  return angle

def isCloseTo90(angle, tolerance=20):
  return abs(angle - 90) < tolerance

def getContourCenter(contour):
  minX = min(contour[:, 0, 0])
  maxX = max(contour[:, 0, 0])
  minY = min(contour[:, 0, 1])
  maxY = max(contour[:, 0, 1])
  averageX = int((minX + maxX) / 2)
  averageY = int((minY + maxY) / 2)
  return averageX, averageY
