D-uality/BitFusion-Robocup-Asia-Pacific/RPi Zero 2W/version_4_short_long_range/victims.py

import cv2
import numpy as np
from imageTransform import *
from config import *

def validateVictims(circles, green, red):
  approvedCircles = []
  draw = True

  for(x, y, r) in circles:
    if  y > 30  and y < REDUCTION_HEIGHT / 2\
    and y != REDUCTION_HEIGHT and y != 0 \
    and x != REDUCTION_WIDTH  and y != 0 \
    and red[y][x] == 0 \
    and green[y][x] == 0: approvedCircles.append((x, y, r))

  if len(approvedCircles) == 0: 
    approvedCircles.append((-1, -1, -1))
    draw = False

  return approvedCircles, draw

def matchVictims(image, circles, previousCircles, tolorance):
  approvedCircles = []

  for (x1, y1, r1) in circles:
    for (x2, y2, r2) in previousCircles:
      delta = abs(x1 - x2) * 1 + abs(y1 -y2) * 1 + abs(r1 - r2) * 5

      if delta < tolorance and r1 != - 1:
        approvedCircles.append((x1, y1, r1))
        cv2.circle(image, (x1, y1), r1, (255, 0, 0), 1)
        cv2.circle(image, (x1, y1), 1 , (255, 0, 0), 1)

  if len(approvedCircles) == 0:
    approvedCircles.append((-1, -1, -1))

  return approvedCircles, image

def findAverages(circles):
  xTotal, yTotal = 0, 0
  xAverage, yAverage = 0, 0

  for (x, y, r) in circles:
    xTotal += x
    yTotal += y

  xAverage, yAverage = int(xTotal / len(circles)), int(yTotal / len(circles))

  return (xAverage, yAverage, -1)

def findLongVictims(image, gray, green, red):
  circles = cv2.HoughCircles(gray, cv2.HOUGH_GRADIENT, dp=2, minDist=10, param1=55, param2=50, minRadius=20, maxRadius=200)
  
  if circles is not None and len(circles) > 0:
    circles = np.round(circles[0, :]).astype("int")
    circles, draw = validateVictims(circles, green, red)
    
    if draw:
      for (x, y, r) in circles:
        cv2.circle(image, (x, y), r, (0, 255, 0), 1)
        cv2.circle(image, (x, y), 1, (0, 255, 0), 1)

  else:
    circles = [(-1, -1, -1)]

  return circles, image

def findShortVictims(image, gray, green, red):
  circles = cv2.HoughCircles(gray, cv2.HOUGH_GRADIENT, dp=1.5, minDist=300, param1=80, param2=30, minRadius=40, maxRadius=150)

  if circles is not None:
    circles = np.round(circles[0, :]).astype("int")
    circles, draw = validateVictims(circles, green, red)

    if draw:
      for (x, y, r) in circles:
        cv2.circle(image, (x, y), r, (0, 0, 255), 1)
        cv2.circle(image, (x, y), 1, (0, 0, 255), 1)

  else:
    circles = [(-1, -1, -1)]

  return circles, image
