D-uality/BitFusion-Robocup-Asia-Pacific/RPi Zero 2W/version_4_short_long_range/victimType.py

from config import *
import random
import math

def generateRandomPoints(xCenter, yCenter, radius, numberOfPoints):
  points = []

  while( len(points) < numberOfPoints):
    angle = random.uniform(0, 2 * math.pi)

    r = math.sqrt(random.uniform(0, 1)) * radius
    x = int(xCenter + r * math.cos(angle))
    y = int(yCenter + r * math.sin(angle))

    if x < 0 or y < 0 or x > REDUCTION_WIDTH - 1 or y > REDUCTION_HEIGHT - 1: pass
    else:                                                                     points.append((x, y))

  return points

def isBlack(pixel, threshold):
  return all(value <= threshold for value in pixel)

def typeCheck(circle, image, numberOfPoints):
  if circle[2] == -1: return -1

  points = generateRandomPoints(circle[0], circle[1], circle[2], numberOfPoints)
  blackCount = 0

  for point in points:
    pixel = image[point[1]][point[0]]
    if isBlack(pixel, 50): blackCount += 1

  if blackCount > 6: return 1
  else:              return 0
