D-uality/BitFusion-Robocup-Asia-Pacific/RPi Zero 2W/version_5_spectral_highlight/version_5_spectral_highlight/testing.cpp

#include <stdint.h>
#include "functions.h"
#include <Arduino.h>

void testing() {
  Serial.print("    Testing");

  // run(160, 160, 3000);
  // run(-160, -160, 3000);

  // run(120, 120, 3000);
  // run(-120, -120, 3000);

  // run(120, -120, 3000);
  // run(-120, 120, 3000);

  // run(100, -100);
  
  run(200, 200);
}
