D-uality/BitFusion-Robocup-Asia-Pacific/(commit log)

2024-05-13 Updated technical paper - Added microcontroller/controller explanation - Added servo motor current draw debrief
2024-05-27 Started Basic Design _ TDP Update
    Switch from Fusion to OnShape was sketchy ...
    - Created a dovetail + Battery proof of concept
    - Started all the work on robot design and stuff idk
    - TDP, more write up as we go along
    [DoveTail - Battery Holder Dovetail.stl, DoveTail - Test Piece.stl, Servo Frame.stl]
2024-05-29 Initial version
    SBC + Battery + Voltage regulator
    Base boards
    Still need to address the current draw issue
    [Base Board - RPi 5 - Base Board - RPi 5.stl, Base Board - Servos - Servo Base Board.stl, Battery Connector - Battery Connector.stl]
2024-06-05 Added new test designs
    - Camera frame for the mirror
    - A mirror model
    - A linkage for the claw system
    - Updated TDP
    [Camera Frame - Camera Frame.stl, Reflective Mirror - Reflective Mirror.stl]
2024-06-06 More claw design
    - First prototype of grab + lift mechanism, including the new 2 bar linkage that allows for more controlled grabs.
    [Claw - Left Main Arm.stl, Claw - Left Support Arm.stl, Claw - Right Main Arm.stl, Claw - Right Support Arm.stl, Rotating Frame - Rotating Frame.stl, Side Gears - Bevel 1M 20T 41deg.stl, Side Gears - Bevel 1M 23T 49deg.stl]
2024-06-06 Updated Claw Parts
    Finished prototype, revealing:
    -> We may have some difficulty in tucking the claw back into the boundaries of the robot
    -> The system requires wider pieces for the claw
    -> May not work for all ball sizes
    [Claw - Left Main Arm.stl, Claw - Left Support Arm.stl, Claw - Right Main Arm.stl, Claw - Right Support Arm.stl, Claw Mechanism - Left Claw Lower Bound.stl, Claw Mechanism - Left Claw Lower Support.stl, Claw Mechanism - Left Claw Upper Bound.stl, Claw Mechanism - Left Claw Upper Support.stl]
2024-06-08 v1 Claw
    Started Designing the first version of the claw:
    - Removal of top layer
    - Reduced size due to the expected distance of retrieval from the claw
    - Shortened length of main arm
    [Claw - Left Claw.stl, Claw - Left Main Arm.stl, Claw - Left Supporting Bottom.stl, Claw - Left Supporting Top.stl, Claw - Right Claw.stl, Claw - Right Main Arm.stl, Claw - Right Supporting.stl, Claw - Rotating Frame.stl]
2024-06-09 The retreival distance was too small
    Fixed retrieval distance:
    - The force applied when the claw was opened in the direction of the slide was nearly perpendicular, which taking into sin theta, would result in basically no force being exerted in the direction of the slide, which rendered it unable to ope.
    [Claw - Left Claw.stl, Claw - Left Main Arm.stl, Claw - Left Supporting Bottom.stl, Claw - Left Supporting Top.stl, Claw - Right Claw.stl, Claw - Right Main Arm.stl, Claw - Right Supporting.stl, Claw - Rotating Frame.stl]
2024-06-09 Changed Tolerance
    [Claw Mechanism - Left Supporting Arm.stl, Claw Mechanism - Right Supporting Arm.stl]
2024-06-11 First Version of robot?
    [Base Board - RPi 5 - Base Board - RPi 5.stl, Base Board - Servo - Base Board - Servos.stl, Base Board - Servos - Servo Base Board.stl, Battery Connector - Battery Connector.stl, Camera Frame - Camera Frame.stl, Claw Frame - Claw Vertically Up - Claw Frame.stl, DoveTail - Battery Holder Dovetail.stl, DoveTail - Test Piece.stl]
2024-06-14 Changed some designs, started coding
    Still slowly building up the first version of the robot: changed rotating frame, claw frame, added sensors, etcetc
    [Base Board - Claw - Base Board - Claw.stl, Camera Frame - Camera Frame.stl, Claw - Rotating Frame.stl, Claw Mechanism - Left Claw.stl, Claw Mechanism - Left Main Arm.stl, Claw Mechanism - Right Claw.stl, Claw Mechanism - Right Main Arm.stl, Robot - Base Board - Claw.stl]
2024-06-16 Added back frame
    -Added back frame
    - Changed the holes for claw base
    [Back Frame - Back Frame.stl, Base Board - Claw - Base Board - Claw.stl]
2024-06-17 Added proper back frame
    Moved the logic level converter onto components board, as I fear there would be too many wires running out of the back
    [Back Frame - Back Frame.stl]
2024-06-18 Added new designs
    - Handle
    - Wire Management thing
    - Logic Level converter now located on components board
    [Base Board - Battery - Base Boards - Battery.stl, Base Boards - Controller Board - Controller Base Board.stl, Handle - Handle.stl, Robot - Base Boards - Battery.stl, Robot - Controller Base Board.stl, Wire Manager - Wire Manager.stl]
2024-06-22 Got the rpi working over USB ethernet
    - Added git to rpi
    - cloned repo
    - added teste hello_world
    [Back Frame - Back Frame.stl, Base Board - Battery - Base Boards - Battery.stl, Base Board - Claw - Base Board - Claw.stl, Base Board - Servo - Base Board - Servos.stl, Base Boards - Controller Board - Controller Base Board.stl, Camera Frame - Camera Frame.stl, Handle - Handle.stl, Side Laser Frame - Side Laser Frame.stl]
2024-06-22 i2c works now - using no logic level converter - can work with 0.5 delays, sending "Hello Arduino!" which is 14 bytes (characters)
2024-06-22 added arduino code - changed rpi file name
2024-06-22 delted i2c.py
2024-06-23 Removed TDP cause it was causing conflicts
    [Back Frame - Back Frame.stl, Base Board - Battery - Base Boards - Battery.stl, Base Board - Claw - Base Board - Claw.stl, Base Board - Servo - Base Board - Servos.stl, Base Boards - Controller Board - Controller Base Board.stl, Camera Frame - Camera Frame.stl, Handle - Handle.stl, Side Laser Frame - Side Laser Frame.stl]
2024-06-24 Create IR Sensor Board Frame - IR Sensor Board Frame.stl
    [IR Sensor Board Frame - IR Sensor Board Frame.stl]
2024-06-26 First version of touch
    Added new touch frame + modified camera frame. Used to be a test run, will need moifications
    [Camera Frame - Camera Frame.stl, Robot - Cap Left 1.stl, Robot - Cap Left 2.stl, Robot - Cap Right 1.stl, Robot - Cap Right 2.stl, Robot - Touch Frame Left.stl, Robot - Touch Frame Right.stl]
2024-06-26 New touch
    Changed from pin + slider to dovetail + draft
    [Camera Frame - Camera Frame.stl, Robot - Camera Frame.stl, Robot - Cap Left 1.stl, Robot - Cap Left 2.stl, Robot - Cap Right 1.stl, Robot - Cap Right 2.stl, Robot - Dovetail Left Left.stl, Robot - Dovetail Left Right.stl]
2024-06-26 Forgot to change the right side dovetails
    [Robot - Dovetail Left Left.stl, Robot - Dovetail Left Right.stl, Robot - Dovetail Right Left.stl, Robot - Dovetail Right Right.stl, Robot - Touch Board Left.stl, Robot - Touch Board Right.stl]
2024-06-27 Basic functionality comes to Arduino
    - Laser ToF Data
    - Mode switching
    - Run (Tank) drive
    - Claw control
2024-06-28 Updated w/ mirror laser frame
    [Robot - Side Laser Frame Left.stl, Robot - Side Laser Frame Right.stl, Side Laser Frame - Side Laser Frame.stl]
2024-06-28 Updated laser sensors from single measurement to continuous
2024-06-30 Added colour sensor testing
2024-07-01 color sensor calibration
2024-07-02 Updated Touch model
    Old model was too low to the floor -> would cause issues when trying to go uphill
    Furthermore, the camera is too close to the boards, moved camera down
    [Robot - Camera Frame.stl, Robot - Dovetail Left Left.stl, Robot - Dovetail Left Right.stl, Robot - Dovetail Right Left.stl, Robot - Dovetail Right Right.stl, Robot - Touch Board Left.stl, Robot - Touch Board Right.stl, Robot - Touch Frame Left.stl]
2024-07-03 Design Updates
    - Moved touch pieces up
    - Changed camera depth
    [IR Sensor Board Frame - IR Sensor Board Frame.stl, Robot - Camera Frame.stl, Robot - Dovetail Left Left.stl, Robot - Dovetail Left Right.stl, Robot - Dovetail Right Left.stl, Robot - Dovetail Right Right.stl, Robot - Touch Frame Left.stl, Robot - Touch Frame Right.stl]
2024-07-04 start of camera
2024-07-05 Added more to camera algorithm
2024-07-05 updates on camera.py - removed normalisation of image as it was slowing it down - added spectural highlgiht removal - adjusted HoghCircle Trransform parameters
2024-07-06 added lasers to Rpi
2024-07-06 line following + camera + lasers
    updated some PID stuff
    Added support for ToF to appear on lasers
    Changed Testing mode to Reading (sensors)
2024-07-07 Updates to camera.py - Addded matching images - Validation checks for noise - Transmission of data
    [camera.py, raspberrypi_laser.py]
2024-07-07 Added I2C implementation
    Still working on I2C implementation.
    - Works within separate programs, where the arduino is idle and doing nothing
    - Does not work when arduino is busy ..., will need to change back to serial, or chnage method of communication.
2024-07-08 Updated communications - added ability to continue running evem after failed transmission
    [camera.py]
2024-07-08 Added evaczone for arduino
    - Read data
    - Convert to integer
    - Move forwards till it sees a victim
    - Stop
2024-07-09 More Evacuation Zone
    - Searching towards the victim
    - Aligning towards victim
    - Moving towards victim
    - Lowering claw
    - Moving forwards
    - Grabbing
    - Lifitng
2024-07-10 Added red triangle identification - Communication doesn't seem to be reliable - The HSL needs more fine tuning
    [camera.py, camera_triangle.py]
2024-07-11 syncing with rpi now
    - the delay could be changed into millis()? i think
    - needs fine tuning
2024-07-12 Evac zone improvements
    - Double check for triangle verification
    - Laser distancing from walls
    - increased base speed
    - added searching while turning
    - updated debugging
    - changed to serial communications
    - updated serial comms method for seamless execution, no delays required
2024-07-12 Added type handling
    - Moves to correct triangle
    - Added sequencing as well
    [evacuationZone.cpp, functions.h]
2024-07-13 updated motor controls
    - turns out the side changes were flipped
    - updated triangle data
    [baseFunctions.cpp, evacuationZone.cpp, functions.h]
2024-07-14 Updated triangle detection - initalisation of min values where wrong, leading to the wrong average being calculated
    [camera.py]
2024-07-15 failed attempt at new algorithm - was going to create masks for red, green, white - find where the ball isn't -> therefore we can find where the ball is - filtering for white is too hard - everything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
    [camera.py, imageTransform.py, victims.py]
2024-07-18 Updated lower parts
    - The change in wheels also carries a change in the wheels thickness (10mm -> 15mm), hence now the wheel is rubbing against the touch fram
    - to solve this, simply removing the touch frame and associated parts as it was largely not worth the volume it took up
    [Robot - Camera Frame.stl, Robot - Dovetail Left Left.stl, Robot - Dovetail Left Right.stl, Robot - Dovetail Right Left.stl, Robot - Dovetail Right Right.stl, Robot - Side Laser Frame Left.stl, Robot - Side Laser Frame Right.stl, Robot - Touch Frame Left.stl]
2024-07-18 Camera from Lower Parts -> Claw Rotating Fram
    - Moved the camera from lower parts to being moving on the claw itself, giving it a larger range of expression, as well as possibility eliminating noise.
    - Restructured the repo as the claw updates were not located inside the RPi Zero section
    [Back Frame - Back Frame.stl, Base Board - Battery - Base Boards - Battery.stl, Base Board - Claw - Base Board - Claw.stl, Base Board - Servo - Base Board - Servos.stl, Base Boards - Controller Board - Controller Base Board.stl, Camera Frame - Camera Frame.stl, Claw - Spiral Bevel 1M 15T 32deg.stl, Claw - Spiral Bevel 1M 24T 58deg.stl]
2024-07-22 Updated camera position
    - Moved from on claw -> angled underneath
    - fixed the claw base plate
    [Base Board - Claw - Base Board - Claw.stl, Lower Parts (10 deg).stl, Lower Parts (15 deg).stl, Lower Parts (20 deg).stl, Lower Parts (22 deg).stl]
2024-07-26 FIne tuned both short and long range models: - With the recent camera updates, the performance of the algorithm is now much better. - Short range works with 3fps - Long range works with 1fps - Must i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
    [baseFunctions.cpp, camera.py, camera_helper.py, colorSensor.cpp, evacuationZone.cpp, functions.h, imageTransform.py, main.cpp]
2024-07-26 Just realised that trying to display images using windows for debugging really costs memory and processing power: - short range: 3fps -> 6 fps - long range: 1fps -> 1.3 fps - 1080p image: 3fps -> 20 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
    [camera.py, victims.py]
2024-07-26 Minor tweaks on arduino side
    to get rid of stashed changes
2024-07-27 beginning of fusion - will need to add a mode selector, we cannot br running both long and short range, and reducing the possible fps
    [camera.py, imageTransform.py, victims.py]
2024-07-27 Switching mechanism complete - Long -> Long + Short -> Short - Might change thre resolution for long, as it is limiting the processing speed from 7fps -> 1.67 fps whilst doing short - doing communica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
    [camera.py, victims.py]
2024-07-31 updated file name for arduino
2024-08-01 Added scaffolding for v4
    - Added all the necessary components for v4
    - Renames v1 for arduino sketch
2024-08-01 Nornalised Data - Managed to get all the x values that appear on the image to be centred, so that the image resolution does not affec the data that is transmitted to the arduino - Fixed problems with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
    [camera.py, config.py, dataTransmission.py, victims.py]
2024-08-02 searchAndApproach
    Arduino data handling started:
    - Evacuation Zone spinning
    - Proportional control loop alignment
    - Proportional control loop forwards movement
2024-08-02 Added triangle identification - Refactored old triangle identification into a single function that is called twice with different contor parameters - updated transmission accordingly - updated the ho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
    [camera.py, config.py, dataTransmission.py, triangles.py, victims.py]
2024-08-03 Added victimType identification - Updtaed some paramebters on the houghCircle for short range
    [camera.py, dataTransmission.py, victimType.py, victims.py]
2024-08-03 updated triangle normalisation - will need to do a time limit for long search in case it's in the air and has really small frame rates
2024-08-03 Updated evaczone logic
    - more data being read from serial
    - PID fixed
    - trying to add presence
    [com_testing.ino, evacuationZone.cpp, functions.h, testing.cpp]
2024-08-08 many bug fixes: - overlaying triangle contours used for hough circle, messing up the settings - removed precense check - updated triangle inRanges - updated contourArea required - removed signal proc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
    [camera.py, camera_triangle.py, dataTransmission.py, imageTransform.py, presenceCheck.py, triangles.py, victims.py]
2024-08-08 more terminal
    - updated run function, now calibrated
    - entire triangle finding sequence + drop sequence
    - added servo_midpoint finder
2024-08-09 Major bugfixes for driveServos and laser
    -lasers kept timing out with continous raning, switching to single measurements
    - servos are not at all in sync with others. did more calibration and rewrote the basic premise of using scalar multiples instead of simply adding constants
    [baseFunctions.cpp, servo_midpoint.ino]
2024-08-09 terminal updates
    - made continuous
    - remade the proper long+short search sequence
    - triangle logic still has some errors - immediately skipping all the alignment at noise for some reason
    [evacuationZone.cpp, functions.h, testing.cpp]
2024-08-11 Adding Line Code.Code written on Arduino IDE for Line Following, Intersections, Obstacle Avoidance, Calibration, Evacuation Zone Rescue, and Integration/Communication with the Pi. Using Teensy 4.1, C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
    Code written on Arduino IDE for Line Following, Intersections, Obstacle Avoidance, Calibration, Evacuation Zone Rescue, and Integration/Communication with the Pi.
    Using Teensy 4.1, Colour Sensors, Laser Sensors, Touch Sensors, Motors, etc.
    [Rescue2024V4.ino]
2024-08-11 Rescue Line V4
    Current version as of now. Still need to add communication with Pi, and tilt sensor for speed boosts on ramps.
2024-08-11 more updates
    - fixed rotation speeds
    - more testing with triangles, still unreliable
    [baseFunctions.cpp, evacuationZone.cpp, testing.cpp]
2024-08-16 solved green triangle issues - genearting points in a circle that is centred with the countor, and then identify black elements
    [triangles.py]
2024-09-01 updated many of the missing design files
    [Camera Frame - Camera Frame.stl, Lower Parts (15 deg).stl, Robot print settings.3mf, Rotating Frame - Rotating Frame.stl, Side Laser Frame.stl]
2024-09-04 Servo Calibration
    - Started servo calibration with bot right
    - Linearization model works
    - able to generate a linear relationship between pwm frequency and the real world anglar speed
    [Servo Calibration.xlsm]
2024-09-05 smol kitty
    my hunnny bunny is the cutest. she is the best and i love her
    [Servo Calibration.xlsm]
2024-09-07 Design changes: Touch
    Touch frame added back in
    claw moved forwards
    [Claw Mechanism - Left Main Arm.stl, Claw Mechanism - Right Main Arm.stl, Lower Parts (15 deg).stl, Robot - Lower Parts.stl, Robot - Slider Left.stl, Robot - Slider Right.stl, Robot - Touch Frame.stl, Rotating Frame - Rotating Frame.stl]
2024-09-07 Updated Triangles, and Calibration values
2024-09-08 More design changes
    [Lower Parts - Lower Parts.stl, Lower Parts - Slider Left.stl, Lower Parts - Slider Right.stl, Robot - Lower Parts.stl, Robot - Slider Left.stl, Robot - Slider Right.stl, Robot - Touch Frame.stl]
2024-09-12 Fixed print messages, and added Triangle into main loop
    [imageTransform.py, main.py, triangles.py, victim.py]
2024-09-25 New claw model
    + Joined everything together into a single piece
    - Any Lego Technic parts, except for the central axle
    [Claw Mechanism - Left Bottom Cuff.stl, Claw Mechanism - Left Claw.stl, Claw Mechanism - Left Main Arm.stl, Claw Mechanism - Left Supporting Arm.stl, Claw Mechanism - Left Top Cuff.stl, Claw Mechanism - Right Bottom Cuff.stl, Claw Mechanism - Right Claw.stl, Claw Mechanism - Right Main Arm.stl]
2024-10-05 Design updates
    [Handle - Tilt Holder.stl, Lower Parts - Touch Frame.stl, Robot - Touch Frame.stl, Robot print settings.3mf, Servo Calibration.xlsm]
2024-10-07 fixed y level validation for live victims
    [triangles.py, victim.py]
2024-10-08 fixing stuff
    [Lower Parts - Touch Frame.stl, Touch Frame Back - Touch Frame Back.stl]
2024-10-12 More design updates
    [Lower Parts - Touch Frame.stl, Servo Frame.stl, Touch Frame Back - Touch Frame Back.stl]
